12003586/PEM-3D-printer/3D Print/Bumper/images/Screenshot_2021-09-20_at_07.13.07.jpg

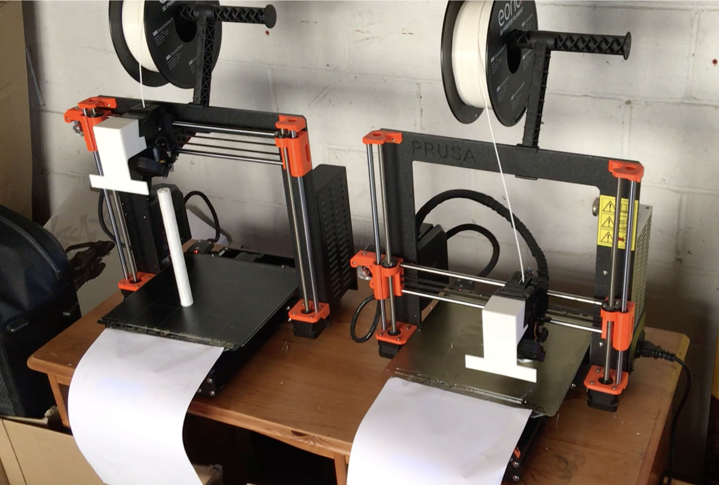
3D Print/Bumper/images/Screenshot_2021-09-20_at_07.13.07.jpg
