12003586/PEM-3D-printer/README.md

# PEM-3D-printer

## Printers
De printers die gebruikt wordt voor dit project is de Prusa i3 MK3S+.
- [Original Prusa i3 MK3S+ 3D printer](https://www.prusa3d.com/product/original-prusa-i3-mk3s-3d-printer-3/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)

Er werd nog gekeken naar een andere printer maar deze was dit jaar niet meer van toepassing. <br>
Het zou een Creality CR-30 geworden zijn.
- [Creality CR-30](https://www.creality.com/products/creality-cr-30-3d-printer)

## Microcontroller
- De Raspberry pi 4 zal gebruikt worden in dit project om hierop de Octopi server te draaien

## Camera
De camera module zal gebruikt worden om livebeelden te voorzien op de Octopi server. <br>
Deze camera module is rechtstreeks verbonden met de Raspberry Pi. 
- [Camera module](https://www.raspberrypi.com/products/camera-module-v2/)

## Bronnen
- [Automated Continuous 3d Printing](https://www.youtube.com/watch?v=NZgjl8W5yrE) </Br>
- [Octoprint](https://github.com/michaelnew/Octoprint-Print-Queue) </Br>
- [Gcode](https://medium.com/swlh/automating-my-3d-printer-81b4f653d4d0) </Br>
- [Prusa MK3S+ Raspberry Pi - Octoprint - Webcam Installation](https://www.youtube.com/watch?v=0FWOMdLVRjg)
- [Continuous Print](https://smartin015.github.io/continuousprint/)</Br>

## Auteurs
- [**Martijn Guilliams**](https://github.com/MartijnGuilliamsPXL) - _CONTRIBUTOR_ -
- [**Bo Mengels**](https://github.com/12003586) - _CONTRIBUTOR_ -
- [**Gijs Jackers**](https://github.com/GijsJackersPXL) - _CONTRIBUTOR_ -
