12003586/PEM-3D-printer/Documentatie/OctoText.md

# OctoText 

OctoText zal werken in octoprint en zal meldingen geven bij de ingestelde vereisten. Deze meldingen gebeuren via SMS of via email. Het enige wat nodig is voor OctoText is een Emailadres met het bijhorende wachtwoord die de mails zal versturen.

### Instelbare vereisten

-	Melding geven bij:
    - Start van print
    - Einde van print
    - Bestand geüpload 
    - Pauze van de print
-	Mail sturen wanneer er een error plaatsvind 

### Configuratie email

SMTP gateway: ```smtp.office365.com```<br>
SMTP Port   : ```587``` 

Username and host address: ```octoprint@outlook.be```
Email password: ```bijhorende wachtwoord voor octoprint@outlook.be```

### Voorbeeld email



of
