12003586/PEM-3D-printer/Documentatie/Bumper.md

## Bumper V1



### V1 geprint

 &nbsp;&nbsp;&nbsp;&nbsp;&nbsp;&nbsp; 


Na printen van de bumper zijn we tot de conclusie gekomen dat deze best opnieuw geprint wordt.

## Bumper V2 
De bumper is aangepast in Fusion 360

Aanpassingen ten opzichte van V1:
- De onderkant is dikker gemaakt 
- De lip aan de binnenkant is kleiner gemaakt
- Zijkant is bijgewerkt zodat er geen verschil meer is


## Bumper V3
Aanpassingen ten opzichte van V2:
- De uitsparing aan de voorkant is 3cm in plaats van 1,5cm
- De lip aan de binnenkant is kleiner gemaakt



## Bumper V4
Aanpassingen ten opzichte van V3:
- De bumper is doorgetrokken naar de zijkant zodat deze ook zijwaarts de print van het printbed kan afduwen.
- De onderkant van bumper is verlengt zodat deze dichter bij het bed kom te zitten en zo ook lage prints kan afduwen.

 

Bij bumper V4 hebben we enkele problemen ondervonden:
- Door een uitsparing te laten tussen de voor en zijkant moet er met support gewerkt worden. Ook dit verhoogt de kans om een misprint.


- Afrondingen van hoeken hebben veel meer kans om de print te laten falen.


## Auteurs
- [**Gijs Jackers**](https://github.com/GijsJackersPXL) - _CONTRIBUTOR_ -
