12003586/PEM-3D-printer/Documentatie/Camera mount.md

# Camera Mount
### Voorstellen om volgende onderdelen te bestellen 
- Flexkabel voor Raspberry Pi camera module (70cm)
  - [Flexkabel](https://www.conrad.be/nl/p/joy-it-rb-camera-0-75-camerakabel-raspberry-pi-1x-csi-1x-csi-0-75-m-wit-1283499.html)
  
### Printen van mount
- https://www.thingiverse.com/thing:3954063


### Extra
- Bouten(M3x20) en bijhorenede moeren 

### Eindresultaat 



## Auteurs
- [**Gijs Jackers**](https://github.com/GijsJackersPXL) - _CONTRIBUTOR_ -
