12003586/PEM-3D-printer/Documentatie/Raspberry pi tijdzone aanpassen.md

# Raspberry pi tijdzone aanpassen [#27](https://github.com/12003586/PEM-3D-printer/issues/27)

 ## Stappen

1. Verbind met SSH met Raspberry Pi 
2. Voer dit commando uit: sudo dpkg-reconfigure tzdata
3. Volg de wizard

[Bron](https://github.com/pablogventura/Octoprint-ETA)

## Auteur
- **Martijn Guilliams** - _CONTRIBUTOR_ - [Martijn Guilliams](https://github.com/MartijnGuilliamsPXL)
