12003586/PEM-3D-printer/Documentatie/PrusaSlicer uitproberen.md

# PrusaSlicer uitproberen [#17](https://github.com/12003586/PEM-3D-printer/issues/17)

## Onderzoek
Bij het exporteren vanuit de Cura slicer voor de Prusa printer werd de print altijd rechtsachter op de printplaat gestart en werd er ook niet standaard een thumbnail aan toegevoegd. 

De printers van Prusa hebben ook een aparte slicer, de PrusaSlicer. Deze slicer is speciefiek gemaakt voor de Prusa printers dus zou het probleem ook moeten oplossen. 

## Testing
De PrusaSlicer zorgt ervoor dat de print in het midden begint en een thumbnail wordt automatisch toegevoegd. Wel is er nog een klein probleem voor tijdens de print de layer count te bekijken. Dit is niet zo erg maar het zou een meerwaarde zijn moest dit gaan.



## Auteur
- **Martijn Guilliams** - _CONTRIBUTOR_ - [Martijn Guilliams](https://github.com/MartijnGuilliamsPXL)
