12003586/PEM-3D-printer/3D Print/Raspberry_Pi_Camera_Mount/files/Raspberry_Camera_mount_clip_right.stl

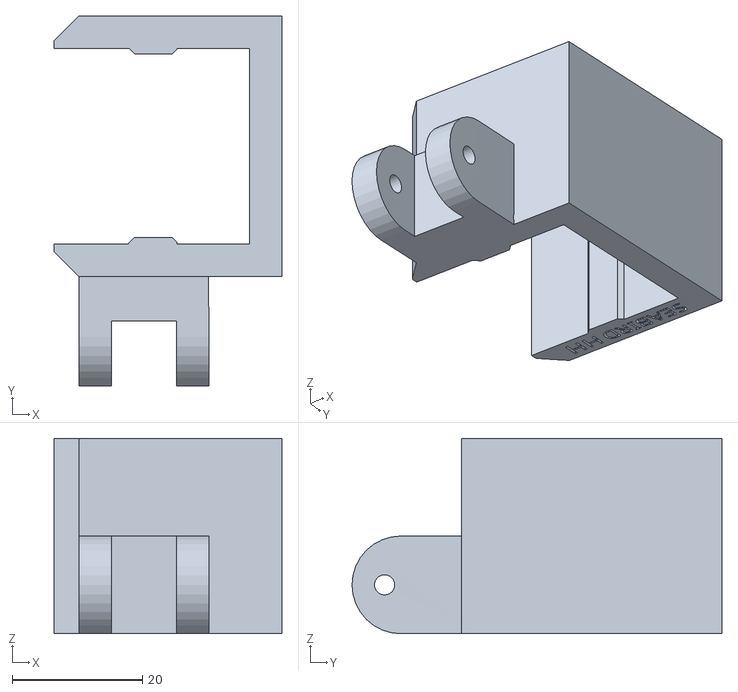
[picture p2: CAD file, 2022-10-10]
3D Print/Raspberry_Pi_Camera_Mount/files/Raspberry_Camera_mount_clip_right.stl
35.0 x 56.8 x 30.0
