12003586/PEM-3D-printer/3D Print/Test printen/stl/Cilinder.stl

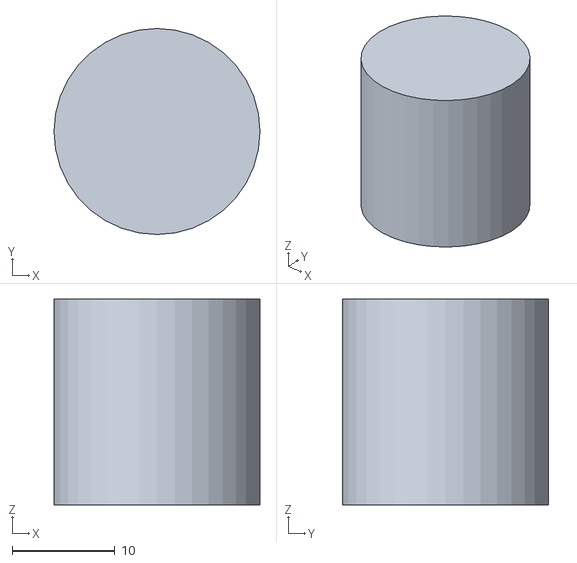
[picture p3: CAD file, 2022-12-05]
3D Print/Test printen/stl/Cilinder.stl
20.0 x 20.0 x 20.0
