12003586/PEM-3D-printer/3D Print/Bumper/files/BumperV4_4.stl

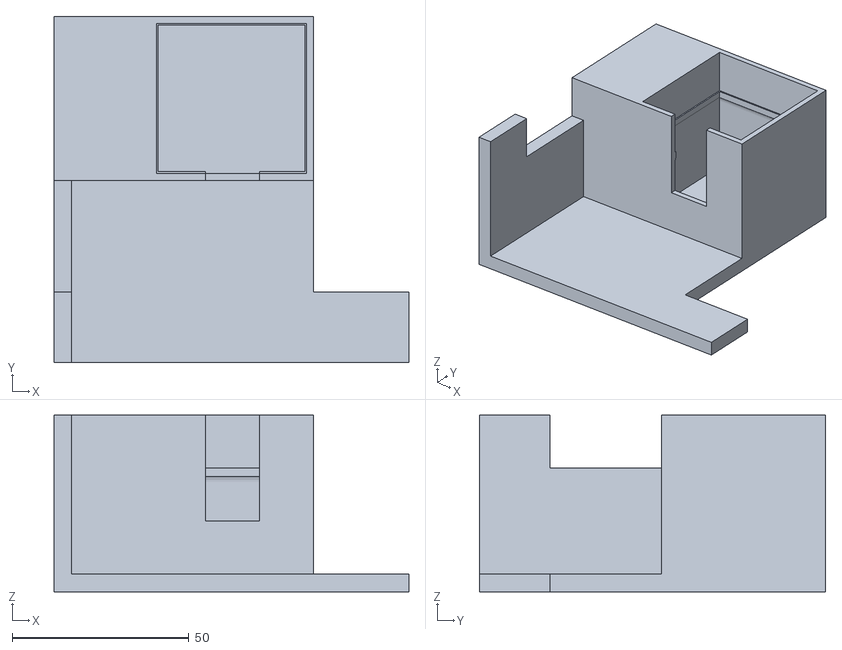
[picture p4: CAD file, 2022-12-05]
3D Print/Bumper/files/BumperV4_4.stl
100.5 x 98.0 x 50.0
