12003586/PEM-3D-printer/3D Print/Raspberry_Pi_Camera_Mount/files/Raspberry_Camera_extender.stl

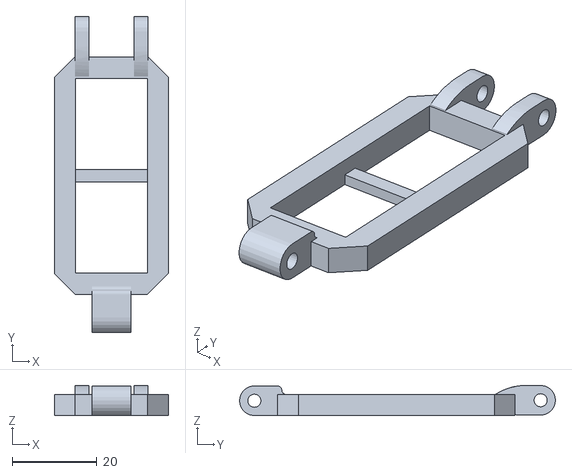
[picture p5: CAD file, 2022-10-10]
3D Print/Raspberry_Pi_Camera_Mount/files/Raspberry_Camera_extender.stl
27.0 x 74.6 x 7.11
