12003586/PEM-3D-printer/3D Print/Raspberry_Pi_Camera_Mount/files/Raspberry_Camera_case_front.stl

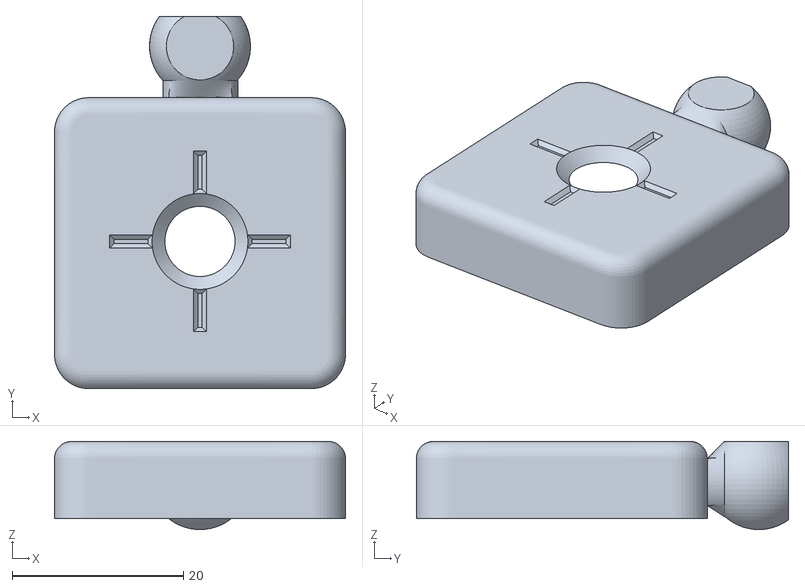
[picture p6: CAD file, 2022-10-10]
3D Print/Raspberry_Pi_Camera_Mount/files/Raspberry_Camera_case_front.stl
34.0 x 43.5 x 10.3
