12003586/PEM-3D-printer/3D Print/Raspberry_Pi_Camera_Mount/files/Raspberry_Camera_case_connector.stl

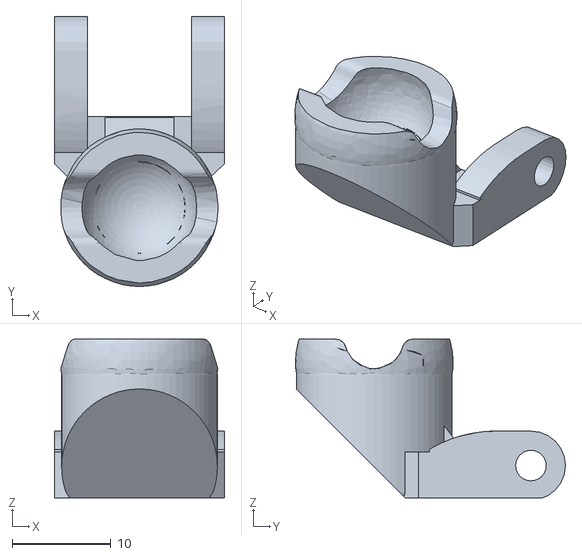
[picture p7: CAD file, 2022-10-10]
3D Print/Raspberry_Pi_Camera_Mount/files/Raspberry_Camera_case_connector.stl
17.3 x 27.4 x 16.1
