12003586/PEM-3D-printer/3D Print/Raspberry_Pi_Camera_Mount/files/Raspberry_Camera_mount_connector.stl

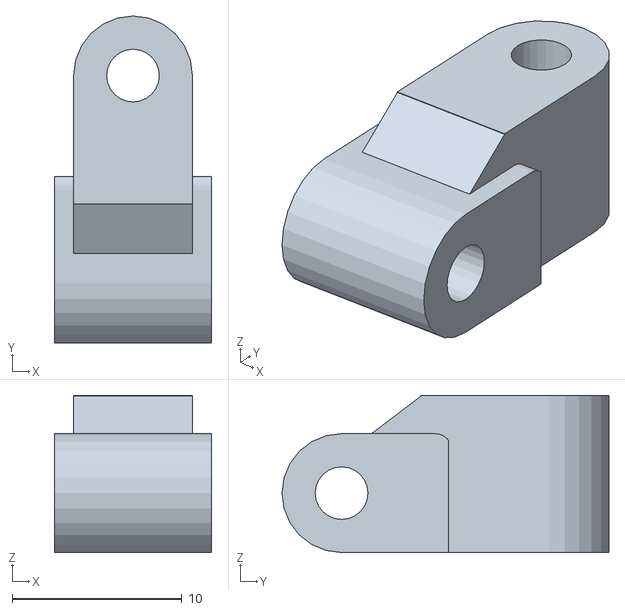
[picture p8: CAD file, 2022-10-10]
3D Print/Raspberry_Pi_Camera_Mount/files/Raspberry_Camera_mount_connector.stl
9.25 x 19.3 x 9.25
