12003586/PEM-3D-printer/3D Print/Bumper/files/BumperV4_3.stl

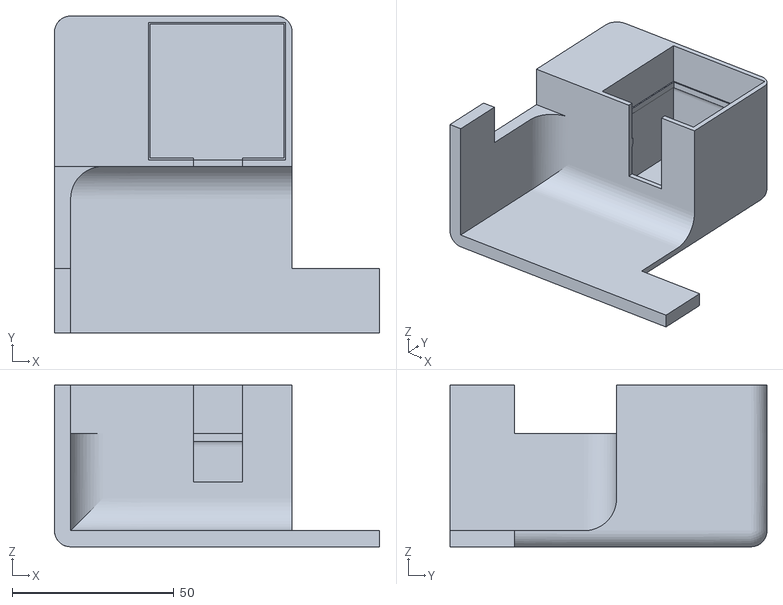
[picture p10: CAD file, 2022-12-05, an earlier design]
3D Print/Bumper/files/BumperV4_3.stl
100.5 x 98.0 x 50.0
