12003586/PEM-3D-printer/3D Print/Bumper/files/BumperV4_2.stl

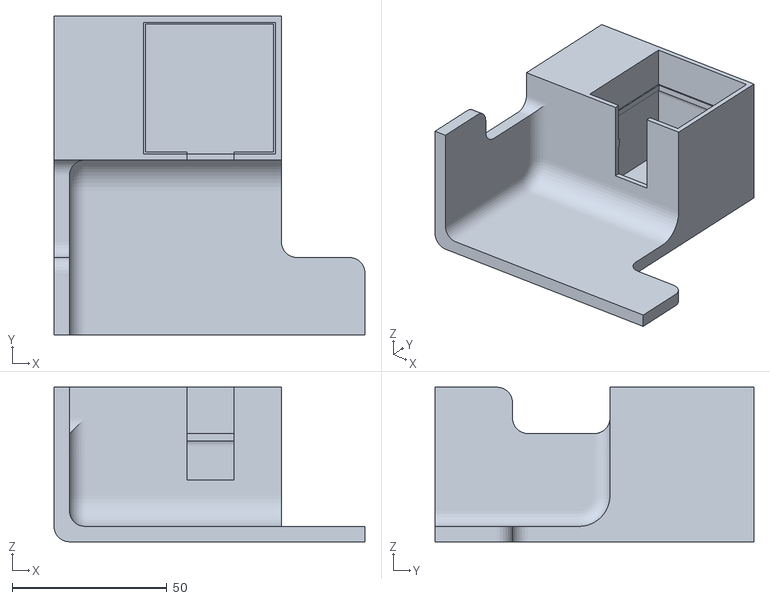
[picture p12: CAD file, 2022-12-05, an earlier design]
3D Print/Bumper/files/BumperV4_2.stl
100.5 x 103.0 x 50.0
