12003586/PEM-3D-printer/3D Print/Bumper/files/BumperV3.stl

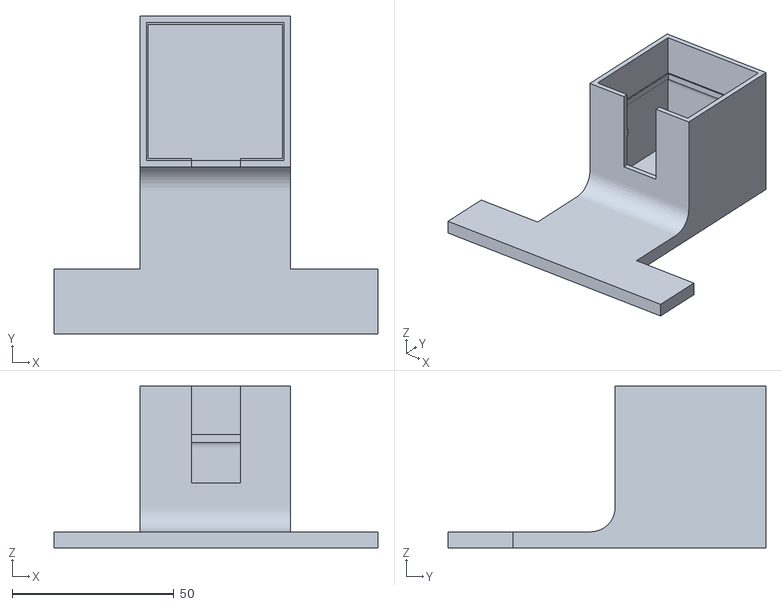
[picture p13: CAD file, 2022-11-21, an earlier design]
3D Print/Bumper/files/BumperV3.stl
100.0 x 98.0 x 50.0
