12003586/PEM-3D-printer/3D Print/Bumper/files/BumperV2.stl

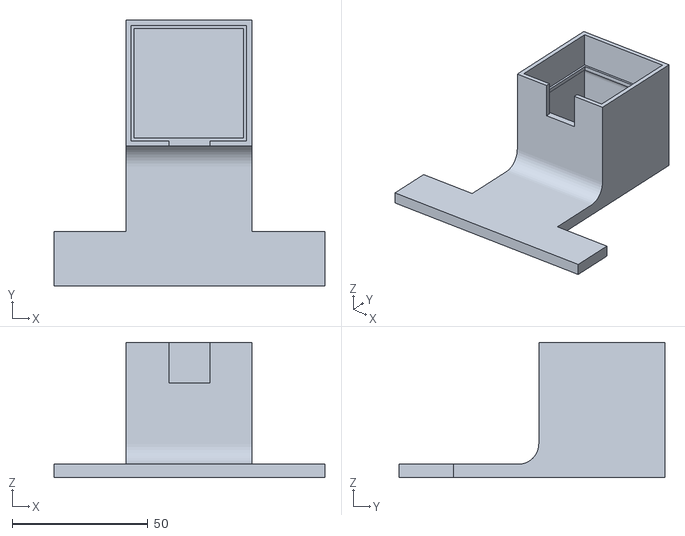
[picture p14: CAD file, 2022-11-07, an earlier design]
3D Print/Bumper/files/BumperV2.stl
100.0 x 98.0 x 50.0
