12003586/PEM-3D-printer/3D Print/Bumper/files/BumperV1.stl

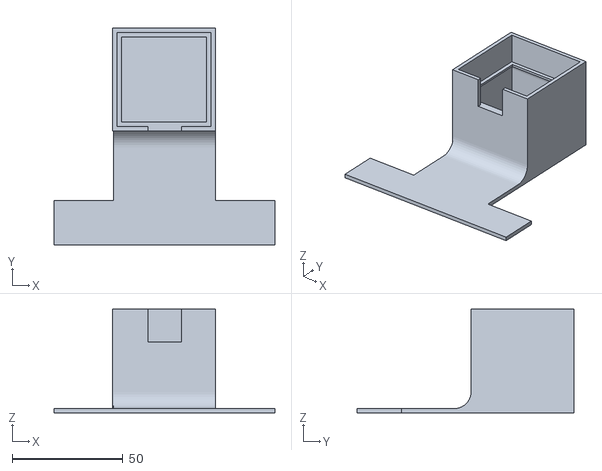
[picture p15: CAD file, 2022-11-07, an earlier design]
3D Print/Bumper/files/BumperV1.stl
100.0 x 98.0 x 47.0
