12003586/PEM-3D-printer/(list of files, cad)

Other CAD files:
3D Print/Raspberry_Pi_Camera_Mount/files/Raspberry_Camera_mount_clip_left.stl
