12003586/PEM-3D-printer/Code/Octoprint-Print-Queue-master/README.md

# OctoPrint-Print-Queue

Deze plugin levert een manier om het ene object na het andere af te drukken. Na het printen van een object zal het een gcode script uitvoeren om het printbed leeg te maken, en zal dan beginnen met het printen van het volgende object in de wachtrij.

Deze plugin werkt alleen als je een manier hebt om het printbed automatisch leeg te maken, hiervoor zal de bumper gebruikt worden.
