12003586/PEM-3D-printer/Documentatie/Print tutorial voor gebruikers.md

# Print tutorial voor gebruikers [#43](https://github.com/12003586/PEM-3D-printer/issues/43)

Dit is een tutorial voor studenten om van een 3d-bestand naar G-code te gaan en deze dan te uploaden op Octoprint.

## Stappenplan
1. Download en installeer [PrusaSlicer](https://www.prusa3d.com/page/prusaslicer_424/) <br>
   Dit gebruiken we omdat deze de minste problemen of beter gezegd minste onhandigheden geeft.
   Andere slicers zouden ook werken maar raden we af zo lang dat er een Prusa printer in gebruik is.
2. Add printer <br>
   Klik op "printer settings" en dan op "add/remove printers".
   Zoek dan de "Original Prusa i3 MK3S & MK3S+" op en selecteer deze met de standaard nozzle.
   (Dit is de printer die nu momenteel gebruikt wordt.)
3. Ga nu naar "print settings"
4. Klik rechtsboven op "Expert"
5. Zorg dat onderstaande settings hetzelfde zijn

   <br> Bij onderstaande foto: let vooral op de "Raft".


6. Druk op opslaan
7. Ga naar "printer settings" en dan naar "Custom G-code" <br>
   Zorg ervoor dat u hetzelfde als de linkerkant heeft, dus het geselecteerde van de rechterkant verwijderen.
   Dit zorgt ervoor de begin lijn of "purge line" niet geprint wordt want dit kan er niet van afgeduwd worden en dit kan dus zorgen voor een verstopping van de hot-end.

8. Druk op opslaan, klik rechtsboven op "Simple" en ga dan naar "Plater"
9. Een STL-file openen <br>
   Een 3d-bestand is vaak een STL-file, hier gaan we dus ook mee verder.
   Het openen kan door het bestand in Prusa te slepen.
8. (LET OP! zorg dat de print niet linksachter in de hoek staat) <br>
   Een print staat standaard in het midden van het printbed.
   Voor hele grote prints raden we te strenge aan om deze naar rechts en naar voor op te schuiven.
   Dit is omdat de print wanneer het gedaan is automatisch er af gaat duwen. Maar omdat de printkop hetgeen is wat de print er van afduwt heeft de printkop linkachter de plaats nodig om terug naar beneden te gaan.
9. Klik nu rechtsonder op "Slice" <br>
   Dit ziet er zo uit. De geschatte printtijd is hier ook zichtbaar.

10. Druk rechtsonder op "Export G-code". <br>
    Sla dit bestand ergens tijdelijk op.
11. Ga nu in een browser naar [Octoprint](http://octopi.pxl-ea-ict.be:24081/).
12. Login met de gebruikersnaam en wachtwoord dat u gekregen heeft.
13. Upload het G-code bestand. En klik dan op het plusteken bij uw bestand.

14. In onderstaand tablad kan u vinden wanneer uw print aan de beurt is.

15. Hopen dat de print lukt.

## Enkele tips voor mislukte prints
* Ontsmetten van het printbed met alcohol.
* Kijken als de nozzle volledig proper is.
* Zorg ervoor dat de bedheating op 60° staat en de nozzle op 210°.

## Auteurs
- **Martijn Guilliams** - _CONTRIBUTOR_ - [Martijn Guilliams](https://github.com/MartijnGuilliamsPXL)
