12003586/PEM-3D-printer/Documentatie/OctoPrint plugin.md

# OctoPrint plugin
## Nuttige plugins
- [x] DisplayLayerProgress
    - Huidige laag-informatie, de voortgang en andere gegevens van een afdruk via M117 commando's naar het printer-display
    - https://plugins.octoprint.org/plugins/DisplayLayerProgress/
- [x] OctoPrint-PrintTimeGenius
    - Plugin die de remaining time op een betere en accuratere manier berekent.
    - https://plugins.octoprint.org/plugins/PrintTimeGenius/
- [x] FilamentManager
    - Deze OctoPrint plugin helpt bij het beheren van uw filamentspoelen
    - https://plugins.octoprint.org/plugins/filamentmanager/
- [x] Firmware Updater
    - Hiermee kunt u direct vanuit OctoPrint voorbereide firmware naar uw printer flashen
    - https://plugins.octoprint.org/plugins/firmwareupdater/
- [x] FileManager
    - Een simpel bestandsbeheer voor OctoPrint
    - https://plugins.octoprint.org/plugins/filemanager/
- [x] OctoText
    - Stuur tekstberichten over veelvoorkomende printergebeurtenissen
    - https://plugins.octoprint.org/plugins/OctoText/
- [x] Print Job History
    - Houd een logfile bij van alle printjobs die er aangemaakt zijn
    - https://plugins.octoprint.org/plugins/PrintJobHistory/
- [x] Slicer Thumbnails
    - https://github.com/jneilliii/OctoPrint-PrusaSlicerThumbnails
    - Deze plugin haalt ingebouwde thumbnails uit gcode bestanden
- [x] Continuous print
    - https://github.com/nukeem/continuousprint
- [ ] OctoPrint-BedReady
    - Plugin die de camera en opencv gebruikt om te bepalen of het bed overeenkomt met een referentiebeeld dat aangeeft dat het bed vrij is en klaar om een afdruk te starten
    - https://plugins.octoprint.org/plugins/bedready/
- [ ] Obico
    - Controleer en bedien uw OctoPrint aangesloten printer overal met Obico
    - https://plugins.octoprint.org/plugins/obico/
- [ ] Simple Emergency Stop
    - Een noodstopknop toevoegen aan de navigatiebalk
    - https://plugins.octoprint.org/plugins/simpleemergencystop/
- [ ] OctoPod / OctoPrint-OctoPod 
    - Deze plugin stuurt onmiddellijk een melding naar uw iOS-apparaten of IFTTT 
    - https://plugins.octoprint.org/plugins/octopod/
- [ ] Exclude Region
    - Voegt de mogelijkheid toe om afdrukken binnen rechthoekige of cirkelvormige gebieden van het huidige actieve gcodebestand te voorkomen.
    - https://plugins.octoprint.org/plugins/excluderegion/

- [x] = geïnstalleerd
- [ ] = te installeren

### Stappenplan om plugin te installeren 
1. Klik op het teken van het sleuteltje rechtsbovenaan: <br>
    
    
2. Zoek dan naar "**Plugin Manager**" in de linkerkant  
   
   
3. Klik daarna op "**+Get More**"
5. Zoek naar de plugin die je wilt installeren
7. Als je de plugin heb gevonden die je wilt installeren klik je op "**Install**"

## Auteurs
- [**Gijs Jackers**](https://github.com/GijsJackersPXL) - _CONTRIBUTOR_ -
