12003586/PEM-3D-printer/PEM_3D_Printer_Presentatie_2223.pptx

## 3D printer Project embedded

Martijn Guilliams
Bo Mengels
Gijs jackers

## Intro

- Prusa i3 MK3S+
- Raspberry Pi 4
- OctoPrint (octopi)
- CSI camera module

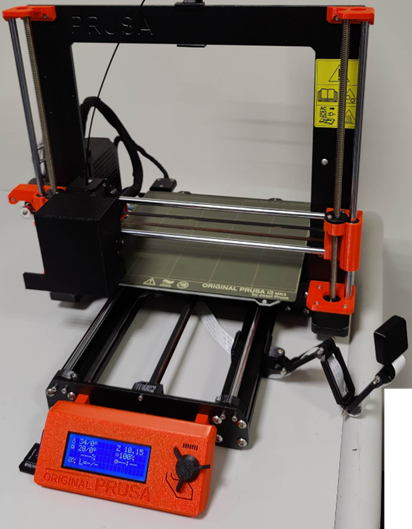
[picture p16: figure]

## Raspberry Pi verbinden met 3D printer

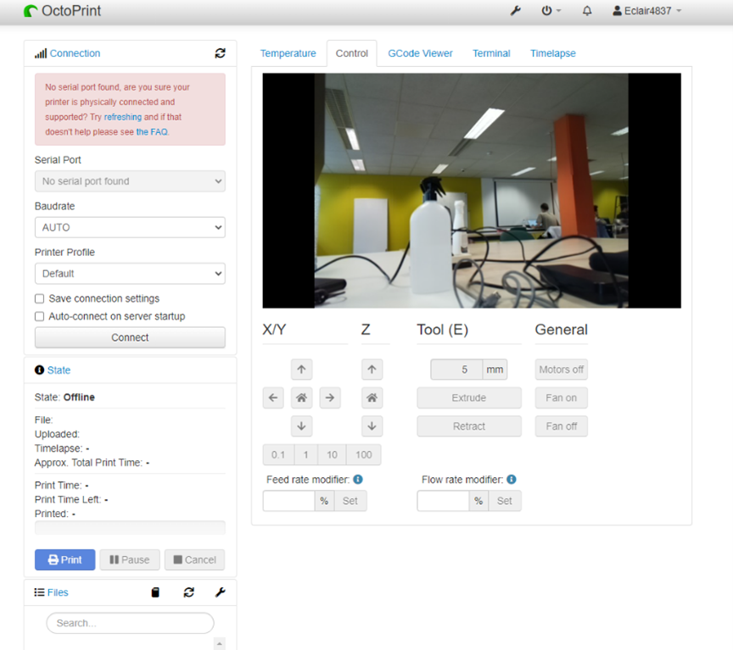
[picture p17: figure]

- Raspberry Pi Imager
- OctoPrint - software

## Firmware updaten van 3D-printer

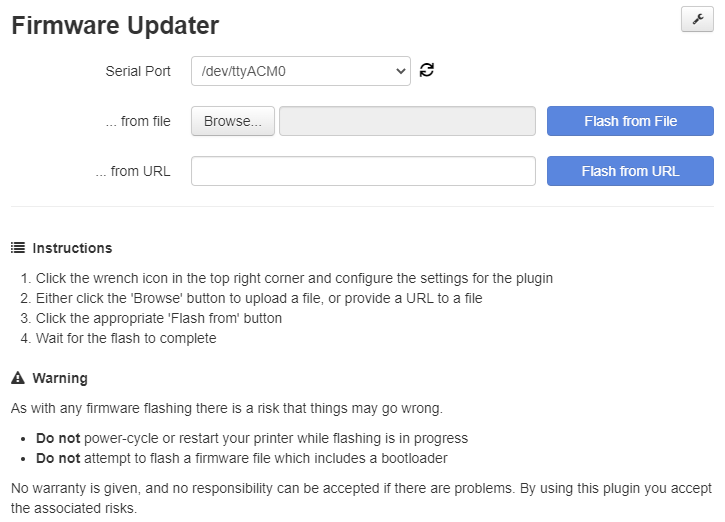
[picture p18: figure]

- FirmwareUpdater
- Specifieke instellingen voor Prusa printer
- Firmware downloaden
- Install

## Continuous Print

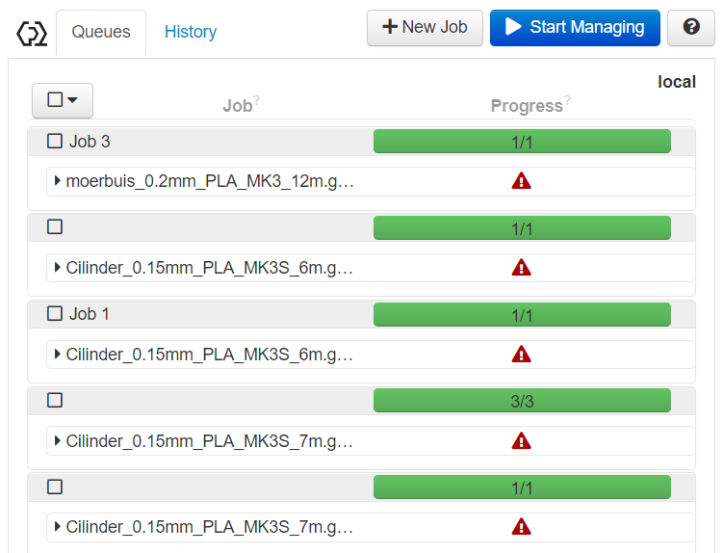
[picture p19: figure]

- Queue
- Bedclearing

## Bedclearing

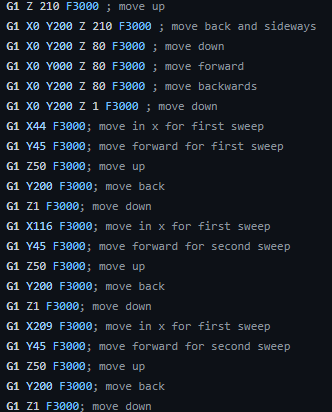
[picture p20: figure]

- Prints van bed verwijderen
- Meerdere sweeps

## Bumper versie 1

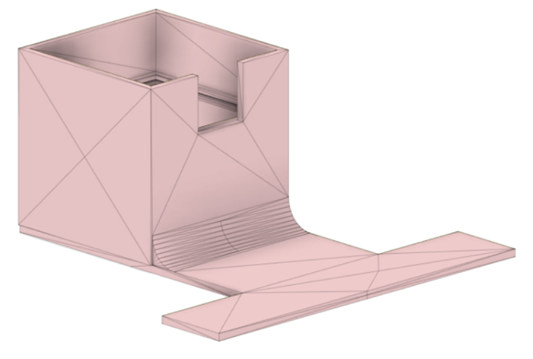
[picture p21: figure]

Minpunten:
- Lip binnenkant te breed
- Onderkant te dun

## Bumper versie 2

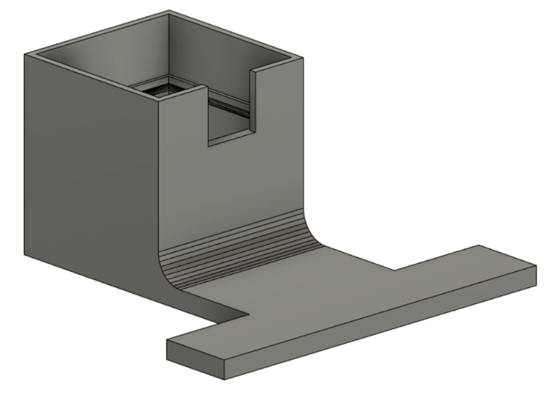
[picture p22: figure]

Verbetering t.o.v. versie 1
- Aanpassing lip (lip/2)
- Achterkant 5mm dik
Minpunten:
- Insnijding te kort

## Bumper versie 3

Verbetering t.o.v. versie 2
- Insnijding langer gemaakt (30mm)
Minpunten:
- Insnijding te kort

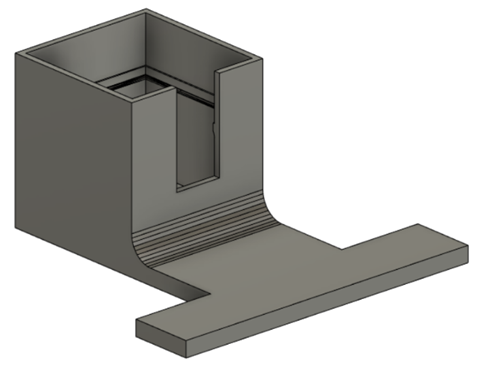
[picture p23: figure]

## Bumper versie 4

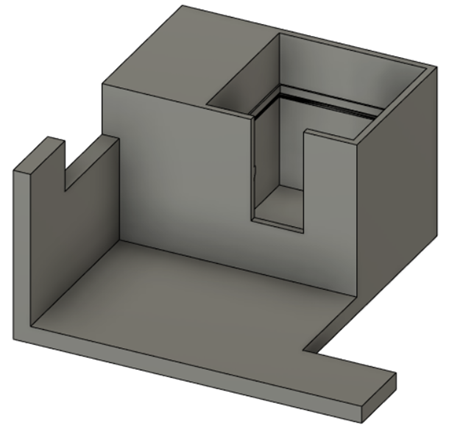
[picture p24: figure]

Verbetering t.o.v. versie 3
- Zijkant bijgevoegd

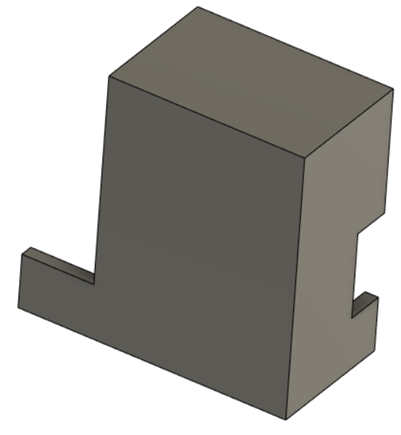
[picture p25: figure]

## Raspberry Pi via SSD

- Stabieler
- Sneller

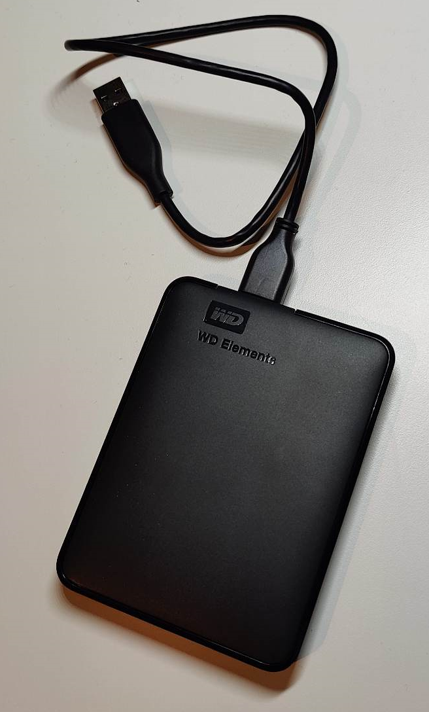
[picture p26: figure]

## CSI Camera

Csi camera <-> Raspberry Pi
Benodigdheden
- Langere camera kabel (75cm)
- Staander voor camera

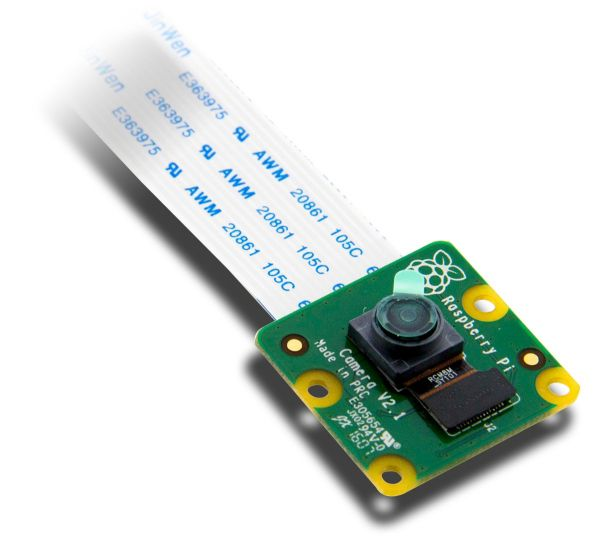
[picture p27: figure]
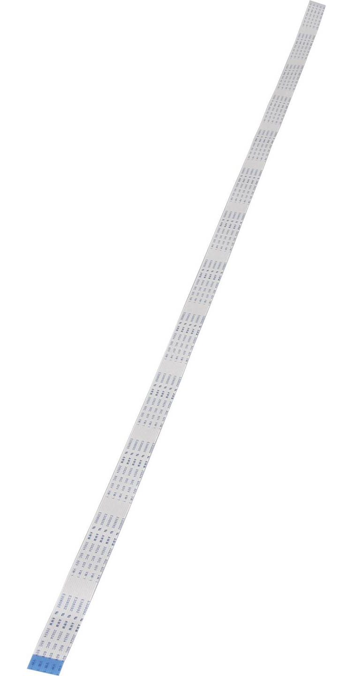
[picture p28: figure]

## Camera staander

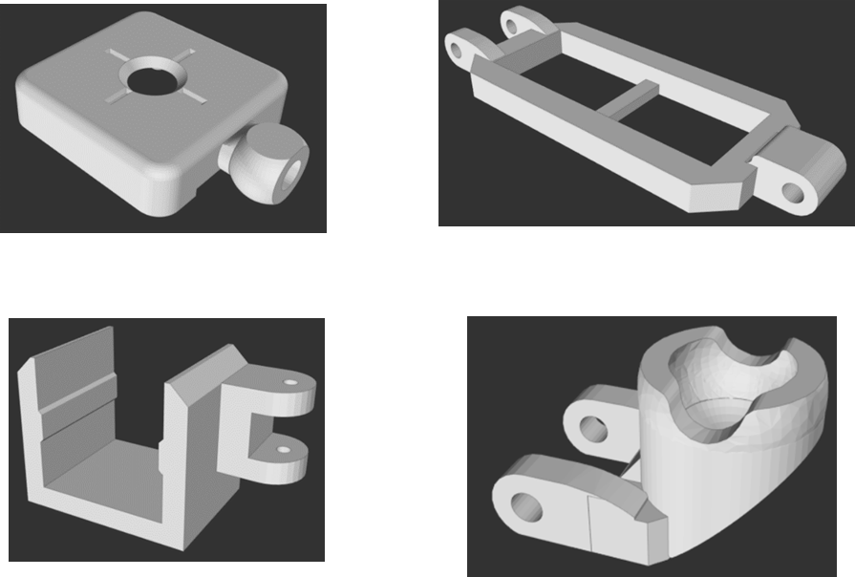
[picture p29: figure]

Staander bestaat uit
- Camera behuizing
- Verlengstuk
- Beugel
- Drager camera behuizing

Camera behuizing

Verlengstuk

Beugel

Drager camera behuizing

## Plugins

- Display layer progress
  - Info / vooruitgang van print naar server sturen
  - Laten zien op printerdisplay
- Print time genius
  - Berekenen printtijd / resterende printtijd
  - Samenwerken met Display layer progress
- Octo text
  - Melding geven bij: start/stop/pauze/einde print
  - Foutmelding mailen
  - Benodigdheden: mailadres + ww

## Log files

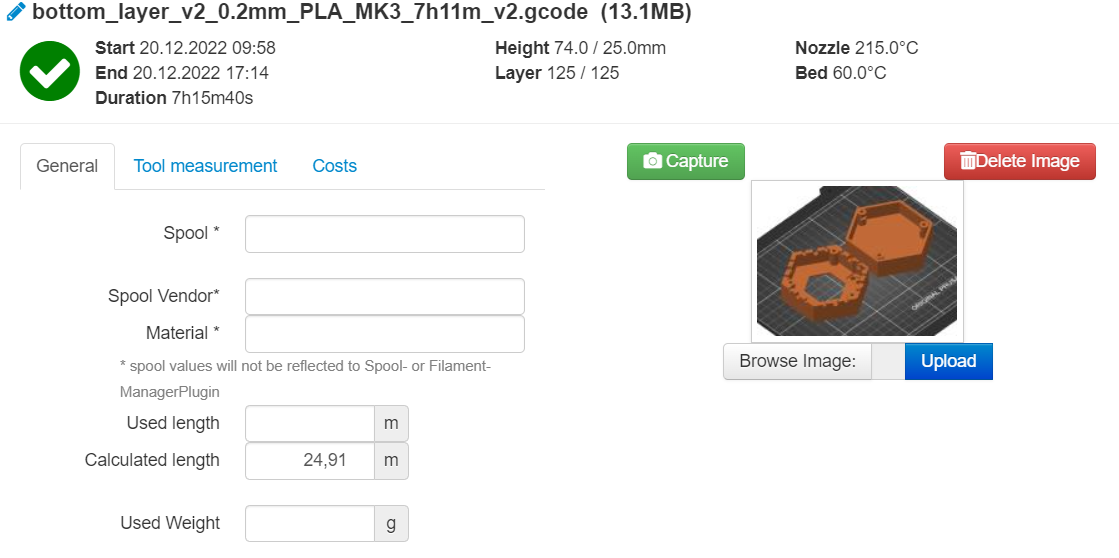
[picture p30: figure]

- overzicht gebruikers
- Korte beschrijving
  - Starttijd
  - Eindtijd
  - Duratie
  - Succesvol of niet

## Script gebruikers

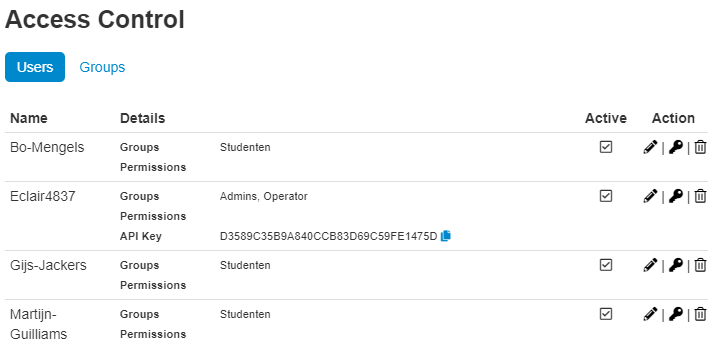
[picture p31: figure]

- API Key
- CSV uitlezen
- Wachtwoord genereren
- Gebruikers aanmaken
- Mail sturen
- Gebruikers verwijderen

## Tutorial voor studenten

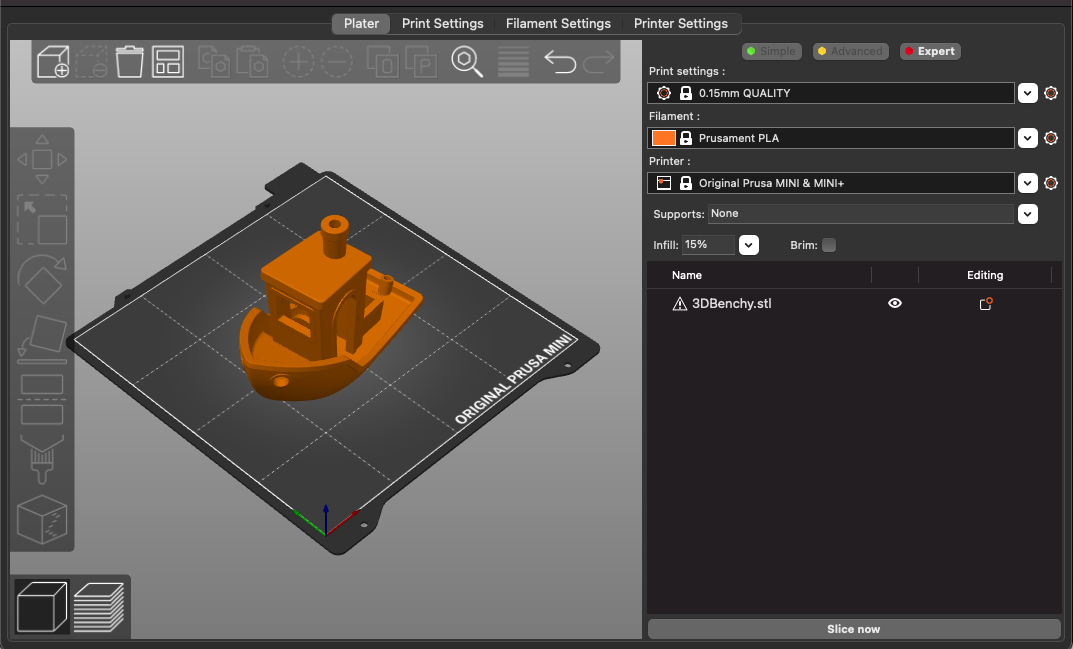
[picture p32: figure]

- PrusaSlicer
- Instelling voor 3d-printer
- Eigen account

## Wan verbinding

- Toegankelijk voor iedereen
- Poort 24081
- http://octopi.pxl-ea-ict.be:24081/

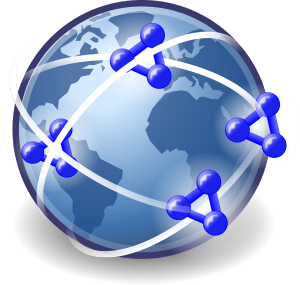
[picture p33: figure]

## Video

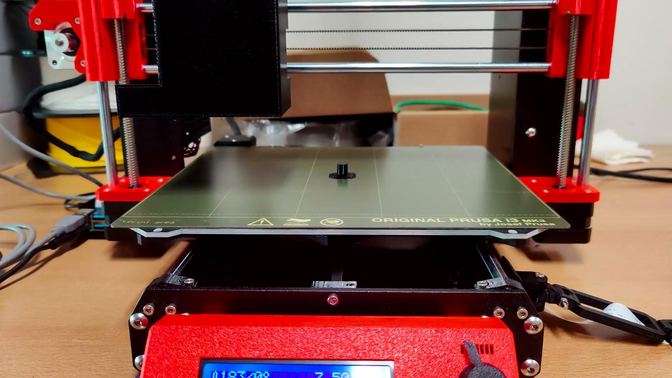
[picture p34: figure]
