12003586/PEM-3D-printer/3D Print/Bumper/images/Body1.png

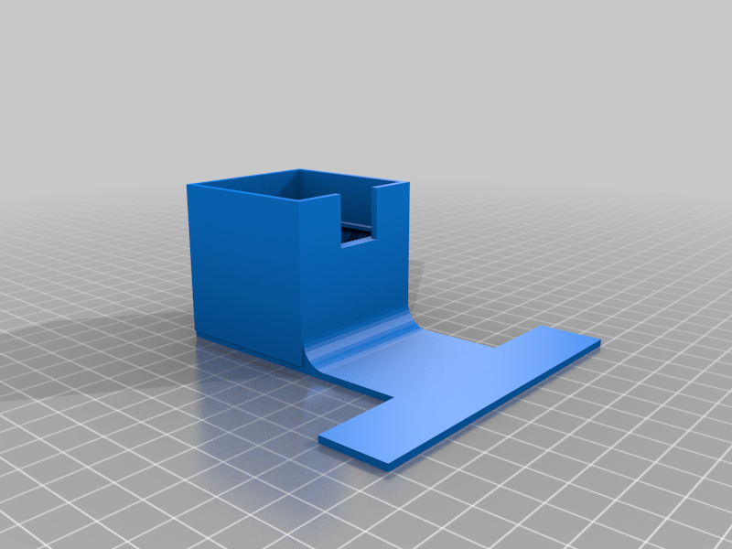
3D Print/Bumper/images/Body1.png
