12003586/PEM-3D-printer/(threads)

Thread 2 (2022-09-19):

Camera verbinden met Raspberry Pi

GijsJackersPXL, 2022-09-19:
https://github.com/12003586/PEM-3D-printer#camera

Sub tickets:
- #9
- #8

GijsJackersPXL, 2022-09-26:
https://www.tomshardware.com/how-to/stream-live-video-raspberry-pi
https://github.com/silvanmelchior/RPi_Cam_Web_Interface
https://www.youtube.com/watch?v=i9mJzdLYsVo
https://www.instructables.com/IP-Camera-Using-the-Raspberry-Pi-Zero-Home-Surveil/

Closed 2022-10-10.

Thread 3 (2022-09-19):

Raspberry Pi met 3d-printer verbinden

GijsJackersPXL, 2022-09-19:
[Raspberry Pi met 3d-printer verbinden.md](https://github.com/12003586/PEM-3D-printer/blob/main/Documentatie/Raspberry%20Pi%20met%203d-printer%20verbinden.md)

Sub tickets:
- #6
- #7

MartijnGuilliamsPXL, 2022-09-19:
[Raspberry Pi met 3d-printer verbinden.md](https://github.com/12003586/PEM-3D-printer/blob/main/Documentatie/Raspberry%20Pi%20met%203d-printer%20verbinden.md)

MartijnGuilliamsPXL, 2022-09-26:
#6

Closed 2022-10-10.

Thread 12 (2022-09-26):

Positionering camera

GijsJackersPXL, 2022-09-26:
Langere kabel:
- 50 / 70 / 100 cm?

Camera mount:
- thingiverse?

GijsJackersPXL, 2022-10-03:
Camera mount: https://www.thingiverse.com/thing:3954063

GijsJackersPXL, 2022-11-21:
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

De flexkabel is binnengekomen en zal onmiddellijk geïnstalleerd worden.

Closed 2022-12-05.

Thread 5 (2022-09-26):

Bumper printen

12003586, 2022-09-26:

GijsJackersPXL, 2022-10-24:
[Bumper.md](https://github.com/12003586/PEM-3D-printer/blob/main/Documentatie/Bumper.md)

GijsJackersPXL, 2022-11-07:
Er moet een V2 van de bumper gemaakt worden.

GijsJackersPXL, 2022-11-21:
Er moet een V3 van de bumper gemaakt worden.

GijsJackersPXL, 2022-11-21:
BumperV3 is geprint en past over de extruder.

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

Closed 2022-12-11.

Thread 9 (2022-09-26):

onderzoek - Raspberry Pi camera

GijsJackersPXL, 2022-09-26:
EPIC:
- #2

GijsJackersPXL, 2022-09-26:
https://www.tomshardware.com/how-to/stream-live-video-raspberry-pi
https://github.com/silvanmelchior/RPi_Cam_Web_Interface
https://www.youtube.com/watch?v=i9mJzdLYsVo
https://www.instructables.com/IP-Camera-Using-the-Raspberry-Pi-Zero-Home-Surveil/

Closed 2022-10-10.

Thread 17 (2022-10-05):

PrusaSlicer uitproberen

MartijnGuilliamsPXL, 2022-10-05:
De gcode van de Cura slicer ingesteld voor de Prusa printer werkt niet via octoprint. Daarom zal de PrusaSlicer uitgeprobeerd worden.
[PrusaSlicer uitproberen.md](https://github.com/12003586/PEM-3D-printer/blob/main/Documentatie/PrusaSlicer%20uitproberen.md)

Closed 2022-10-10.

Thread 21 (2022-10-10):

WAN verbinding

MartijnGuilliamsPXL, 2022-10-10:

GijsJackersPXL, 2022-10-24:
Er worden poorten opengezet op het elektronica netwerk.

12003586, 2023-01-07:
Er is een poort opengezet door Bart en octoprint kan via wan verbinding bereikt worden via:
http://octopi.pxl-ea-ict.be:24081/#temp

GijsJackersPXL, 2023-01-08:
Gecontroleerd en werkt zoals het hoort.

Closed 2023-01-08.

Thread 25 (2022-10-10):

Opzoeken Raspberry Pi via ssd

12003586, 2022-10-10:

12003586, 2022-10-10:
https://github.com/12003586/PEM-3D-printer/blob/main/Documentatie/Raspberry%20Pi%20met%203d-printer%20verbinden.md

Closed 2022-10-10.

Thread 30 (2022-10-24):

Script gebruikers

MartijnGuilliamsPXL, 2022-10-24:
Met dit script kan er voor elke leerling een User worden aangemaakt met een random wachtwoord die automatisch via mail wordt door gestuurd naar die leerling. Als elke leerling een eigen account heeft kan er via de logging van Octoprint gekeken worden welke gebruiker wat geprint heeft.

Deze epic is ook de samenvoeging van onderstaande scripts tot één script. De Gebruikers-verwijderen is natuurlijk wel een apart script.

[Documentatie](https://github.com/12003586/PEM-3D-printer/blob/main/Documentatie/Script%20gebruikers%20aanmaken.md)
[Code](https://github.com/12003586/PEM-3D-printer/blob/main/Code/Script-gebruikers/Script-gebruikers.py)

Sub tickets:
- #39
- #40
- #41
- #42
- #44
- #45

GijsJackersPXL, 2022-12-11:
Allemaal gecontroleerd!

Closed 2022-12-11.

Thread 32 (2022-11-07):

Bumper file aanpassen

GijsJackersPXL, 2022-11-07:
[Bumper](https://github.com/12003586/PEM-3D-printer/blob/main/Documentatie/Bumper.md)

GijsJackersPXL, 2022-11-07:
Bumper file is aangepast en de aanpassingen zijn in de markdown genoteerd

Closed 2022-11-07.

Thread 39 (2022-11-21):

Gebruikers-aanmaken

MartijnGuilliamsPXL, 2022-11-21:
Een script om een octoprint gebruiker aan te maken.

[Documentatie](https://github.com/12003586/PEM-3D-printer/blob/main/Documentatie/Script%20gebruikers%20aanmaken.md)
[Code](https://github.com/12003586/PEM-3D-printer/blob/main/Code/Script-gebruikers/gebruikers-aanmaken.py)

Epic:
- #30

GijsJackersPXL, 2022-12-11:
Deze code is getest geweest en er wordt een gebruiker aangemaakt.

Closed 2022-12-11.

Thread 40 (2022-11-21):

Gebruikers-aanmaken-command-test

MartijnGuilliamsPXL, 2022-11-21:
Een script om een http post command naar octoprint te testen.
In dit voorbeeld werd een reboot post gebruikt, omdat hier geen extra data meegestuurd moest worden.

[Documentatie](https://github.com/12003586/PEM-3D-printer/blob/main/Documentatie/Script%20gebruikers%20aanmaken.md)
[Code](https://github.com/12003586/PEM-3D-printer/blob/main/Code/Script-gebruikers/gebruikers-aanmaken-command-test.py)

Epic:
- #30

GijsJackersPXL, 2022-12-11:
Deze code is getest geweest en er wordt een gebruiker aangemaakt.

Closed 2022-12-11.

Thread 42 (2022-11-21):

Gebruikers-aanmaken-wachtwoord-genereren

MartijnGuilliamsPXL, 2022-11-21:
Een script om automatisch een random wachtwoord te genereren voor een gebruiker.

[Documentatie](https://github.com/12003586/PEM-3D-printer/blob/main/Documentatie/Script%20gebruikers%20aanmaken.md)
[Code](https://github.com/12003586/PEM-3D-printer/blob/main/Code/Script-gebruikers/gebruikers-aanmaken-wachtwoord-genereren.py)

Epic:
- #30

GijsJackersPXL, 2022-12-11:
Deze code is getest geweest en er wordt een uniek wachtwoord gegenereerd.

Closed 2022-12-11.

Thread 44 (2022-12-05):

Gebruikers-aanmaken-csv

MartijnGuilliamsPXL, 2022-12-05:
Een script om een csv bestand uit te lezen. Dit kan gebruikt worden om een csv lijst met mailadressen van leerlingen uit te lezen en voor elke leerling een account aan te maken.

[Documentatie](https://github.com/12003586/PEM-3D-printer/blob/main/Documentatie/Script%20gebruikers%20aanmaken.md)
[Code](https://github.com/12003586/PEM-3D-printer/blob/main/Code/Script-gebruikers/gebruikers-aanmaken-csv.py)

Epic:
- #30

GijsJackersPXL, 2022-12-11:
Deze code is getest geweest en de CSV lijst wordt ingelezen + een account wordt gemaakt.

Closed 2022-12-11.

Thread 45 (2022-12-05):

Gebruikers-verwijderen

MartijnGuilliamsPXL, 2022-12-05:
Een script om automatisch alle aangemaakte gebruikers uit een csv lijst weer te verwijderen van Octoprint.

[Documentatie](https://github.com/12003586/PEM-3D-printer/blob/main/Documentatie/Script%20gebruikers%20aanmaken.md)
[Code](https://github.com/12003586/PEM-3D-printer/blob/main/Code/Script-gebruikers/gebruikers-verwijderen.py)

Epic:
- #30

GijsJackersPXL, 2022-12-11:
Deze code is getest geweest en er worden gebruikers verwijderd die in de CSV lijst staan.

Closed 2022-12-11.
