12003586/PEM-3D-printer/(commit log)

2022-09-19 Create Raspberry Pi met 3d-printer verbinden.md
2022-09-19 Update Raspberry Pi met 3d-printer verbinden.md
2022-09-26 code octoprint
    [babel.cfg]
2022-10-03 Create Camera Mount.md
2022-10-03 Rename Camera Mount.md to Camera mount.md
2022-10-10 Update README.md
    Printers aanpassen
2022-10-10 Rpi camera gcode
    [Raspberry_Camera_case_back.stl, Raspberry_Camera_case_connector.stl, Raspberry_Camera_case_front.stl, Raspberry_Camera_extender.stl, Raspberry_Camera_mount_clip_left.stl, Raspberry_Camera_mount_clip_right.stl, Raspberry_Camera_mount_connector.stl]
2022-10-17 Create Print Removal Code.gcode
2022-10-17 Update Print Removal Code.gcode
2022-10-17 Create Print Removal Code Prusa mk3.gcode
2022-10-18 Create Raspberry pi tijdzone aanpassen.md
2022-10-18 Update Raspberry pi tijdzone aanpassen.md
2022-10-24 Update Camera mount.md
2022-11-07 Bumper aanpassen
    [Body1.stl, BumperMetAanpassingen.stl]
2022-11-14 Create gebruikers-aanmaken-mail.py
    testen om een mail te sturen via Python
2022-11-14 Create reboot-command-test.py
    testen van een http POST
2022-11-21 update bumper file
    - Uitsparing groter gemaakt
    - Lip binnenkant kleiner gemaakt
    [BumperV1.stl, BumperV2.stl, BumperV3.stl]
2022-11-28 continous print
2022-11-28 einde les
    [BumperV4_1.stl, BumperV4_2.stl, Cilinder.stl]
2022-12-05 Aanpassingen bumper
    [BumperV4_3.stl, BumperV4_4.stl]
2023-01-08 Create Print tutorial voor gebruikers.md
2023-01-08 Update Print tutorial voor gebruikers.md
